joaopako/Inverted-Pendulum/(commit log)

2026-09-02 Add Arduino motor control with PID functionality
2026-09-02 Add motor control and PID functionality
2026-09-03 Add Inverted Pendulum control system
    Implement Inverted Pendulum control logic with PID tuning and motor control.
